adamd9/OSCS/OSCS/BATTERY/1.3mm Port Module v8.step

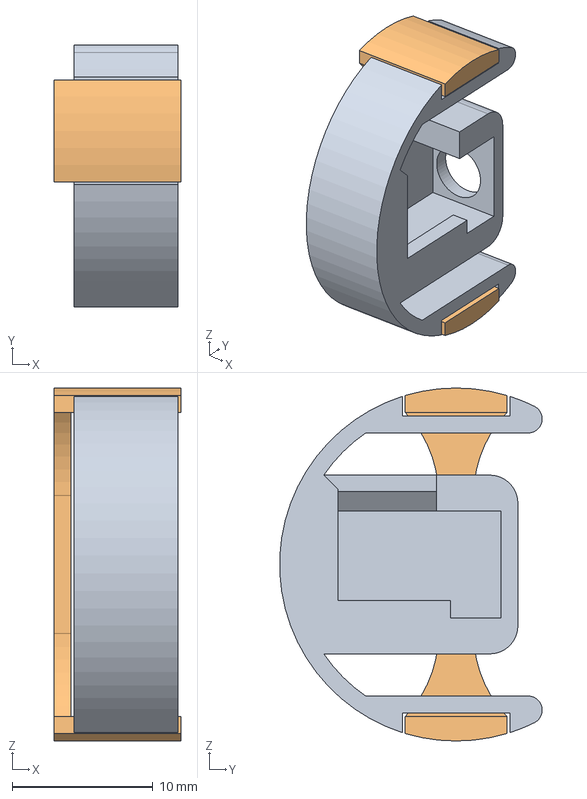
[picture p1: CAD file, 2020-02-17]
OSCS/BATTERY/1.3mm Port Module v8.step
9.00 x 18.7 x 25.1 mm
Port Cradle
Rails
