adamd9/OSCS/OSCS/BUTTONS/Button Retention Module v2.step

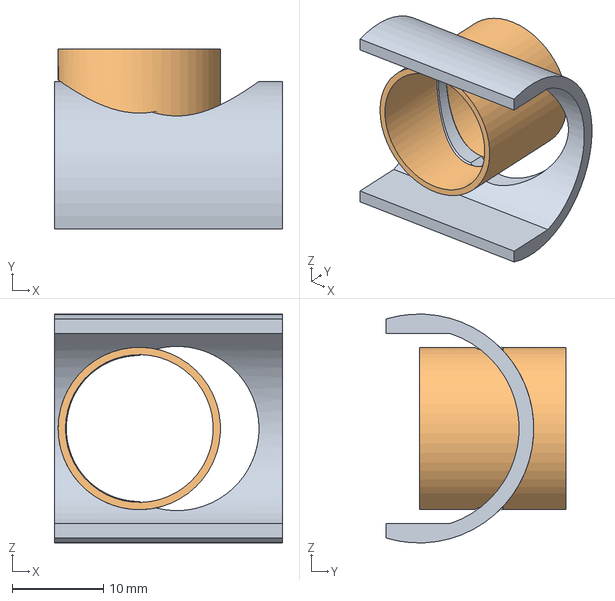
[picture p2: CAD file, 2020-02-17]
OSCS/BUTTONS/Button Retention Module v2.step
25.0 x 19.7 x 25.1 mm
Rails
Button Well
