adamd9/OSCS/OSCS/EXTENSIONS/Dovetail Rail Extension.step

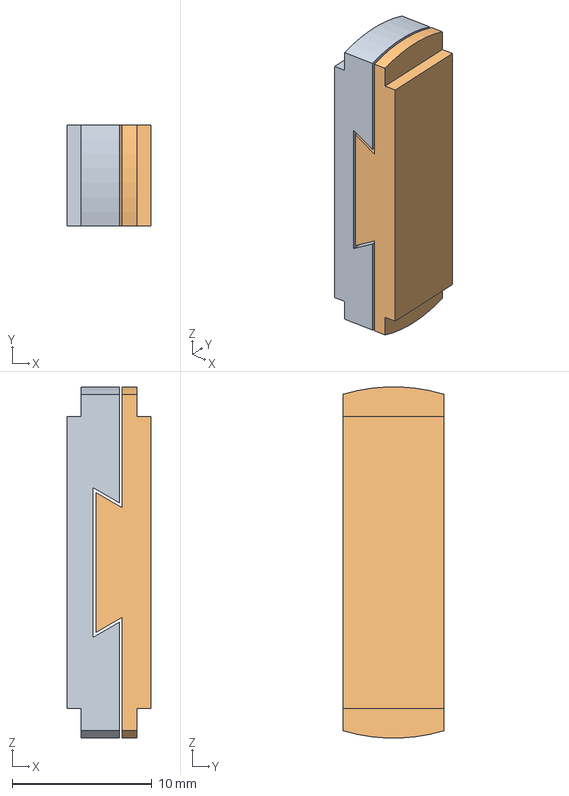
[picture p3: CAD file, 2020-02-17]
OSCS/EXTENSIONS/Dovetail Rail Extension.step
6.00 x 7.25 x 25.1 mm
