adamd9/OSCS/OSCS/LIGHT/TCSS Neopixel Hilt Module v9.step

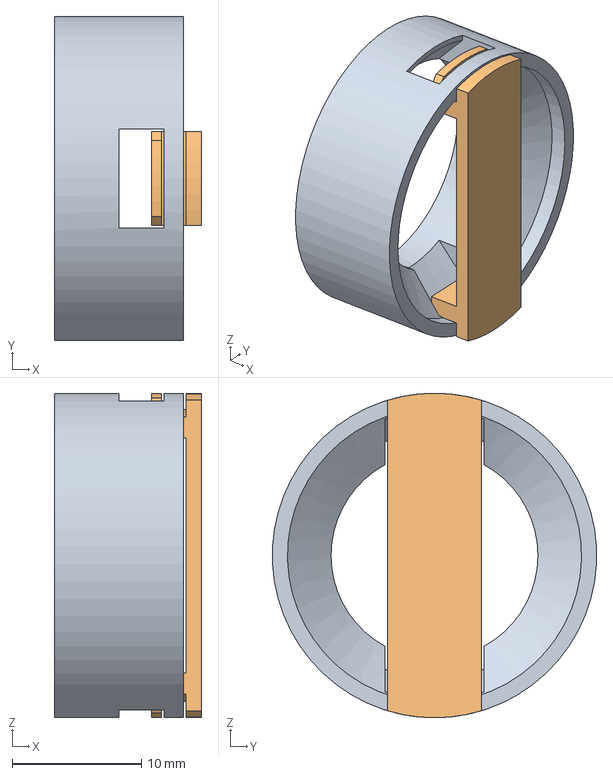
[picture p4: CAD file, 2020-01-21]
OSCS/LIGHT/TCSS Neopixel Hilt Module v9.step
11.4 x 25.1 x 25.1 mm
Neopixel Hilt
Rails
