adamd9/OSCS/OSCS/SOUNDBOARDS/Tilted Proffie Module v3.step

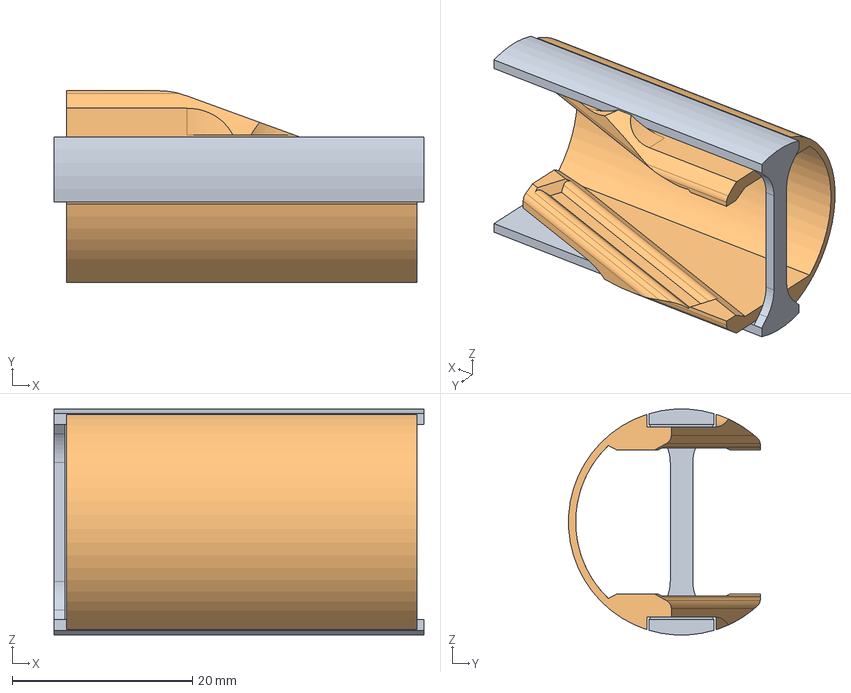
[picture p5: CAD file, 2020-02-19]
OSCS/SOUNDBOARDS/Tilted Proffie Module v3.step
41.0 x 21.3 x 25.1 mm
Rails
Proffie Cradle
