adamd9/OSCS/OSCS/SPEAKERS/28mm Speaker Module v4.step

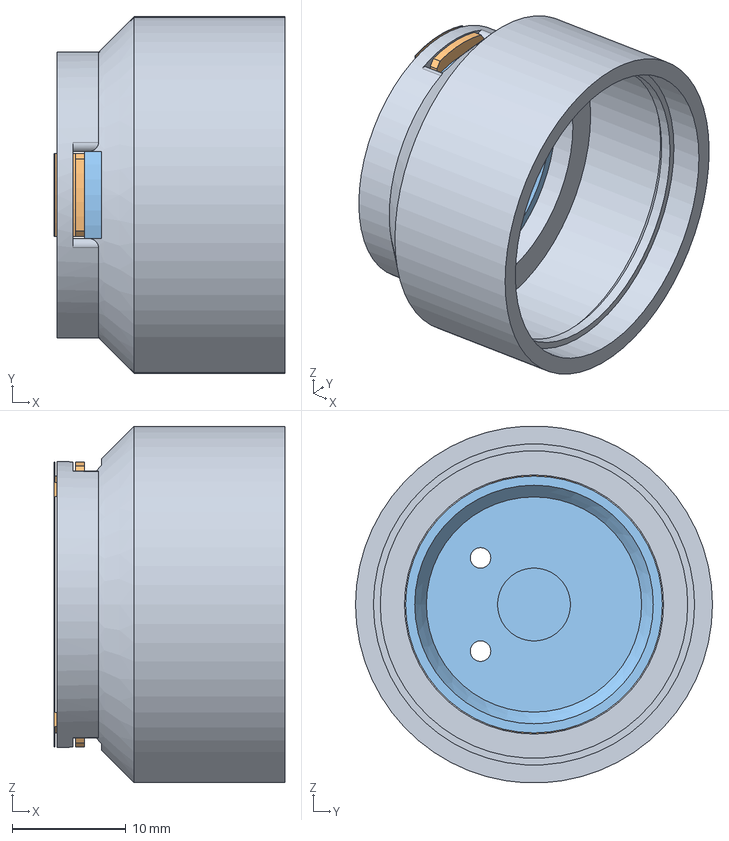
[picture p6: CAD file, 2020-01-21]
OSCS/SPEAKERS/28mm Speaker Module v4.step
20.2 x 31.4 x 31.3 mm
Speaker Housing
Rails
Speaker Backplate
