adamd9/OSCS/OSCS/BUTTONS/16mm Button Module v1.step

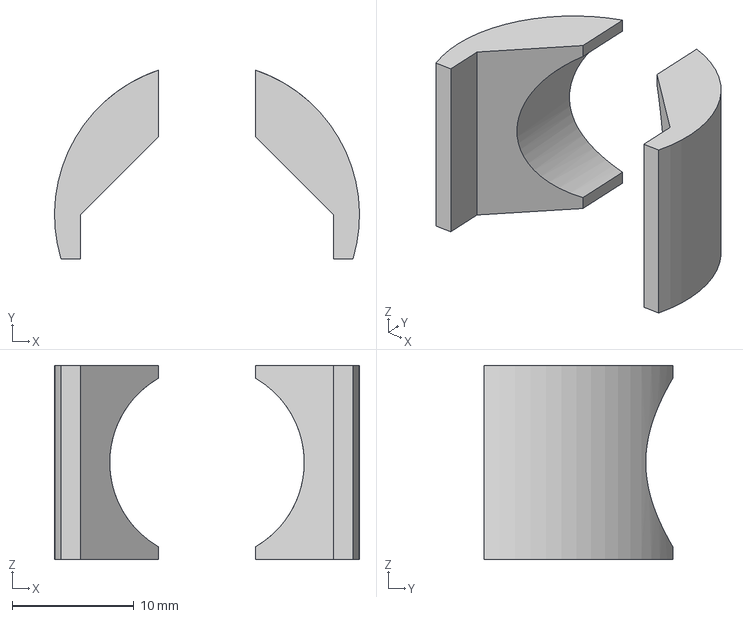
[picture p7: CAD file, 2020-01-27]
OSCS/BUTTONS/16mm Button Module v1.step
25.1 x 15.5 x 16.0 mm
