adamd9/OSCS/OSCS/EXTENSIONS/Removable Chassis Module v38.step

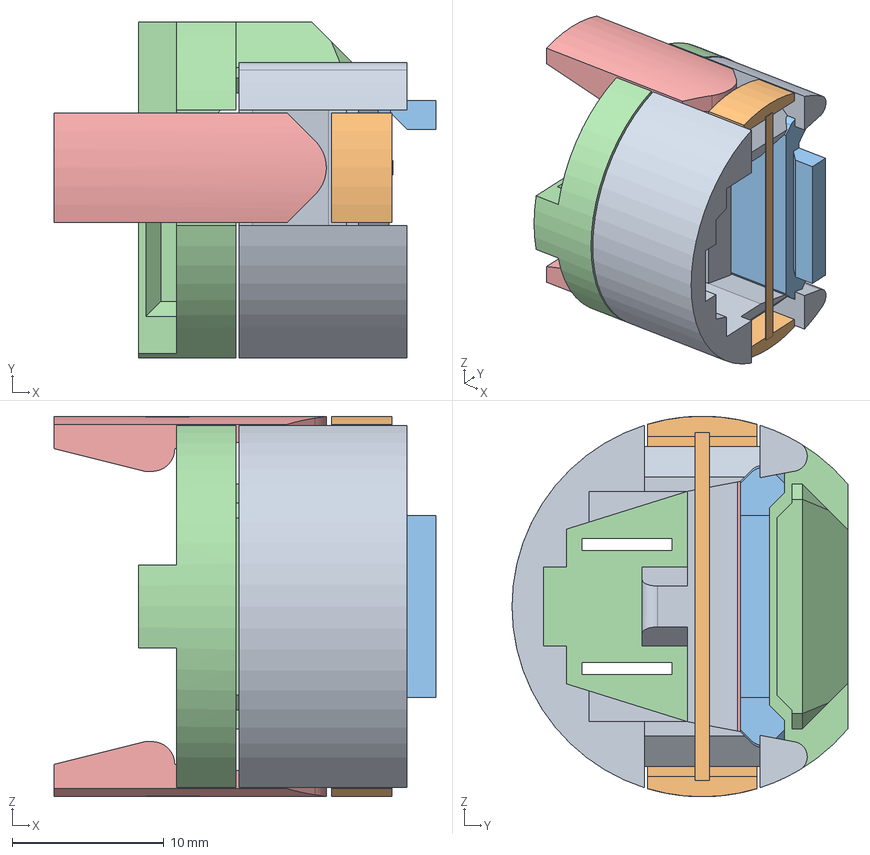
[picture p8: CAD file, 2020-01-21]
OSCS/EXTENSIONS/Removable Chassis Module v38.step
25.2 x 22.2 x 25.1 mm
Chassis Side
Chassis Rails
SD Card Plate
Hilt Side
Hilt Rails
