adamd9/OSCS/OSCS/SPEAKERS/22mm Speaker Module v10.step

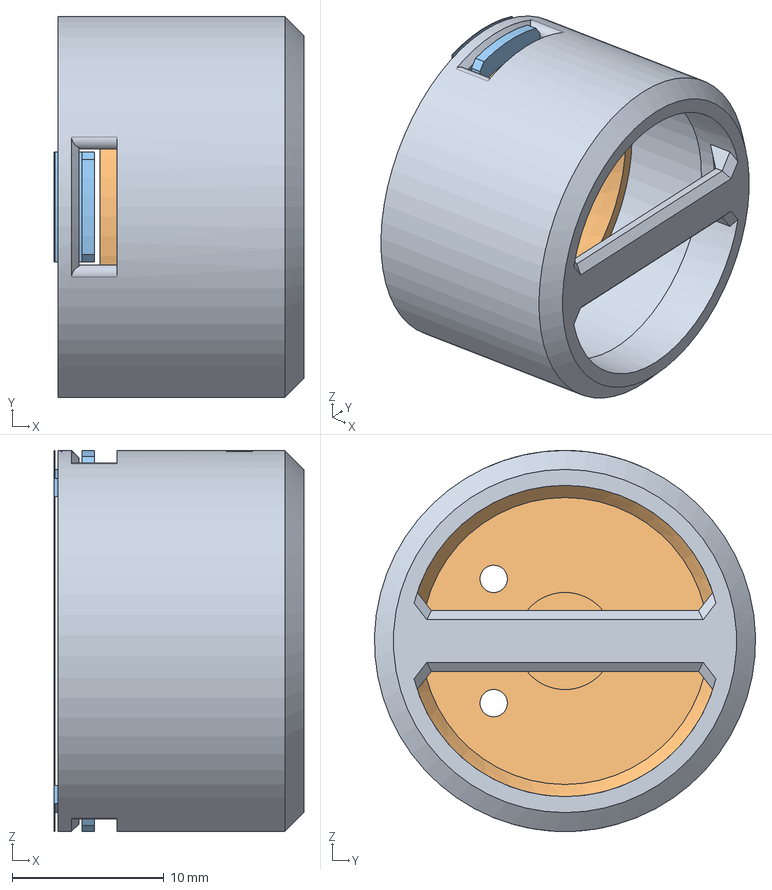
[picture p10: CAD file, 2020-01-10]
OSCS/SPEAKERS/22mm Speaker Module v10.step
16.4 x 25.1 x 25.1 mm
Speaker Housing
Speaker Backplate
Rails
