adamd9/OSCS/OSCS/BATTERY/2.1mm Port Module v4.step

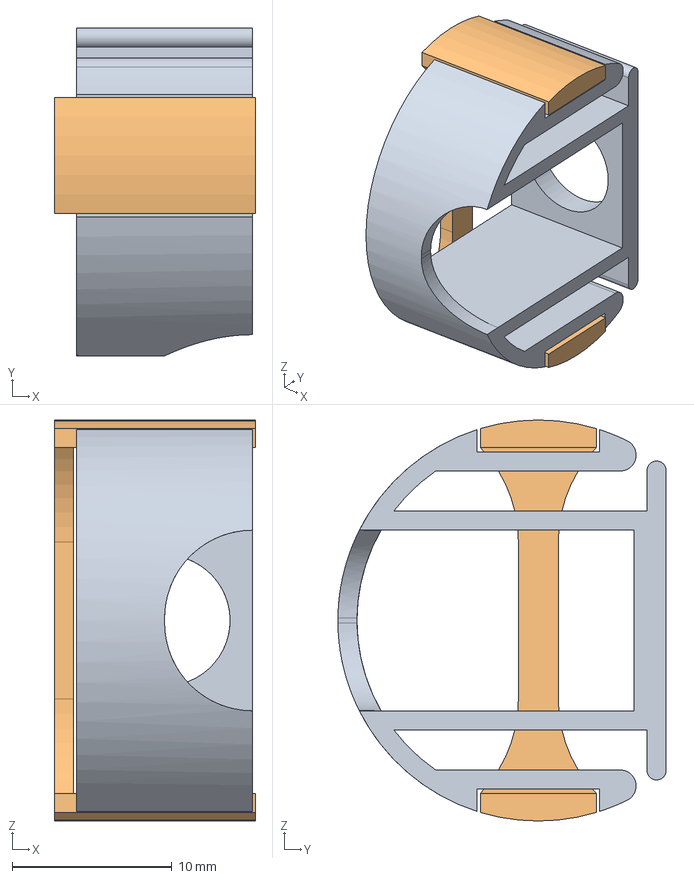
[picture p11: CAD file, 2020-02-17]
OSCS/BATTERY/2.1mm Port Module v4.step
12.6 x 20.6 x 25.1 mm
Port Cradle
Rails
