adamd9/OSCS/OSCS/SOUNDBOARDS/NBv4 Module v13.step

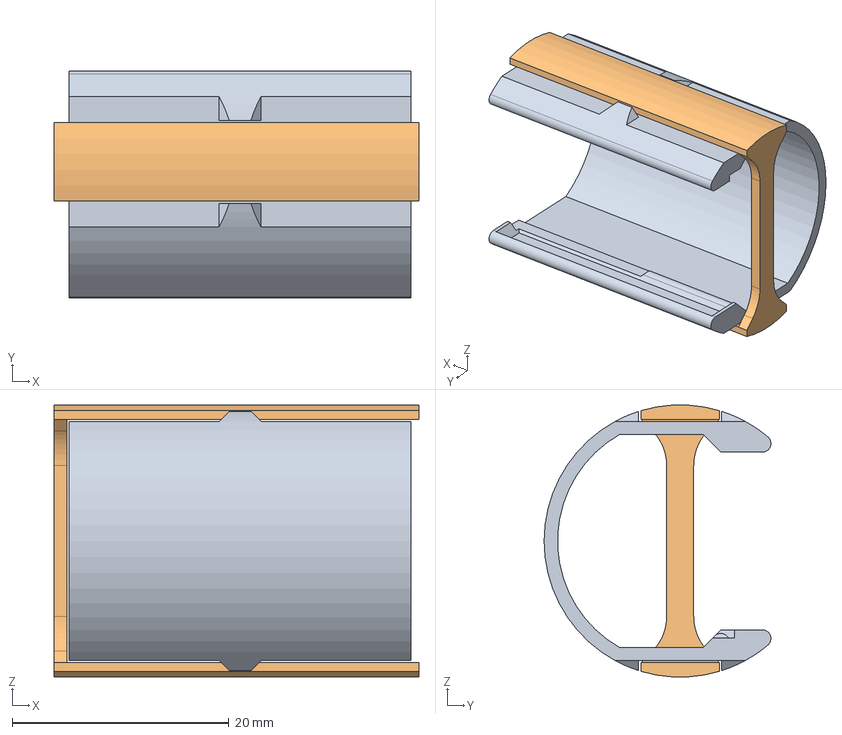
[picture p12: CAD file, 2020-01-21]
OSCS/SOUNDBOARDS/NBv4 Module v13.step
33.6 x 20.9 x 25.1 mm
Board Tray
Rails
