adamd9/OSCS/OSCS/SOUNDBOARDS/CFX Module v2.step

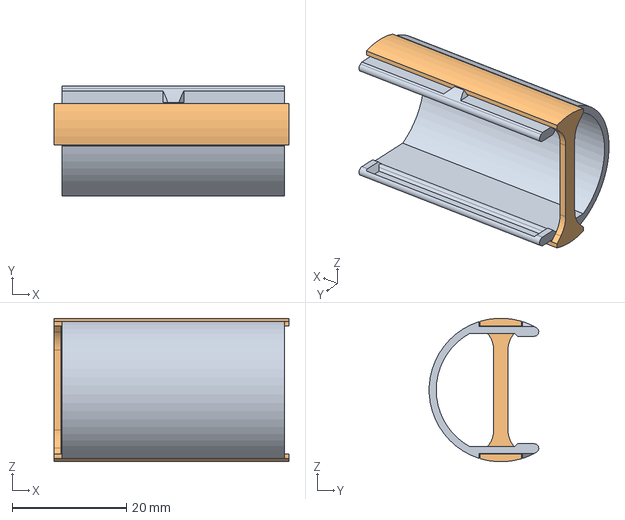
[picture p13: CAD file, 2020-01-21]
OSCS/SOUNDBOARDS/CFX Module v2.step
41.1 x 19.2 x 25.1 mm
Board Tray
Rails
