adamd9/OSCS/OSCS/SOUNDBOARDS/Proffie Module v30.step

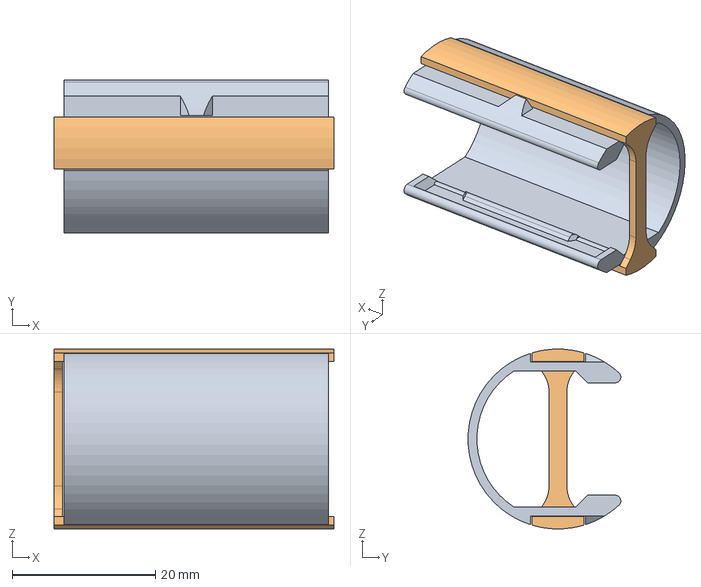
[picture p14: CAD file, 2020-01-21]
OSCS/SOUNDBOARDS/Proffie Module v30.step
39.0 x 21.3 x 25.1 mm
Board Tray
Rails
