adamd9/OSCS/OSCS/BATTERY/21700 Battery Module v16.step

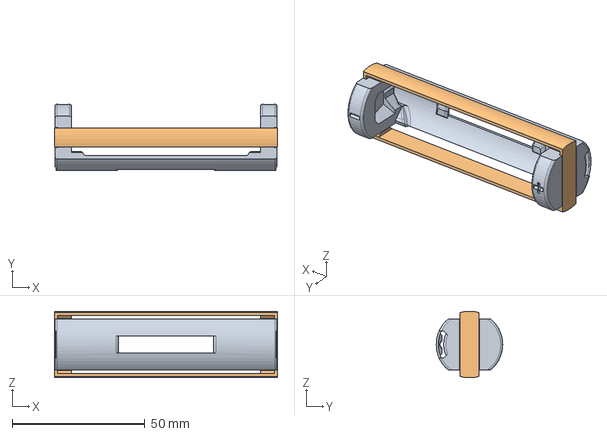
[picture p15: CAD file, 2020-02-17]
OSCS/BATTERY/21700 Battery Module v16.step
84.1 x 25.1 x 25.1 mm
Battery Tray
Rails
