adamd9/OSCS/(list of files, cad)

Other CAD files:
Universal Chassis v17.f3d
